NibblesLab/cmu800midi/(commit log)

2019-04-08 編集中2
2019-04-08 タイトル編集
2019-04-09 編集中4
2019-06-22 MocoLUFAのリンクが誤っていたのを修正
2019-06-22 チューニングトーン発生機能を追加
2019-06-22 チューニングに関する説明を追加
2020-01-10 ピッチベンドの処理を修正&チューンモード設定をチューンリクエスト(0xF6)に変更
2020-01-10 チューニングに関する説明を変更(コントロールチェンジからチューンリクエストへ)
2020-01-18 クロック入力機能を追加
2020-01-18 MIDIクロック発生機能を追加
2021-12-18 無音時のノイズを低減
2021-12-18 参考サイトを追加
